Wierus/GarageClock/Data/Photo/Device.JPG

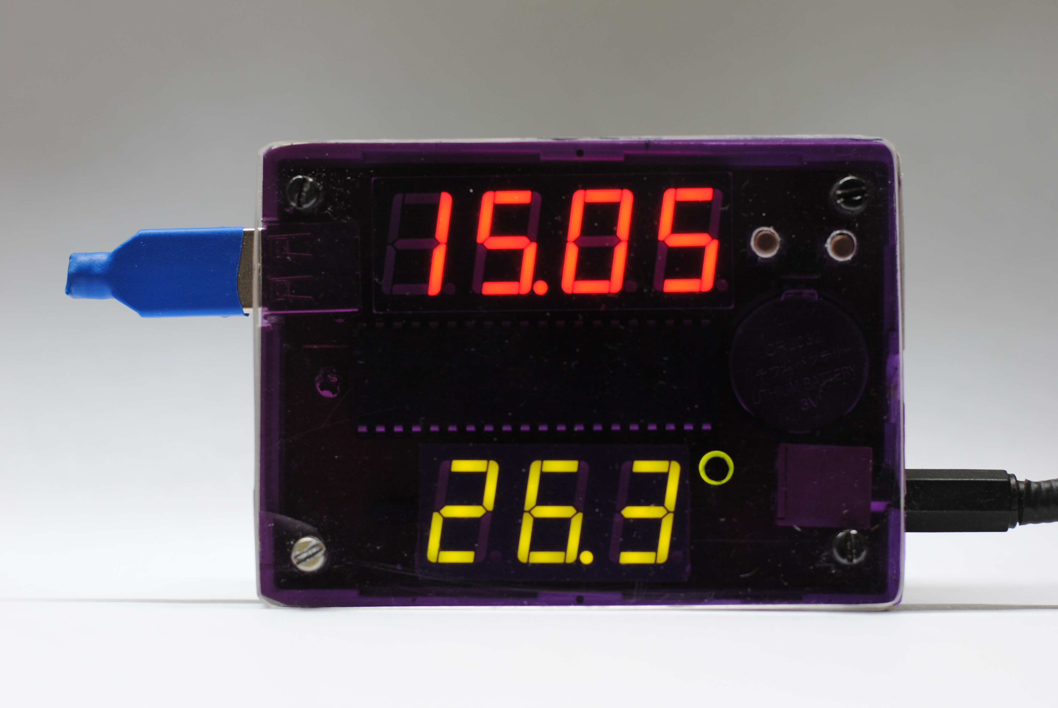
Data/Photo/Device.JPG
