Wierus/GarageClock/Data/Photo/PCB Back.JPG

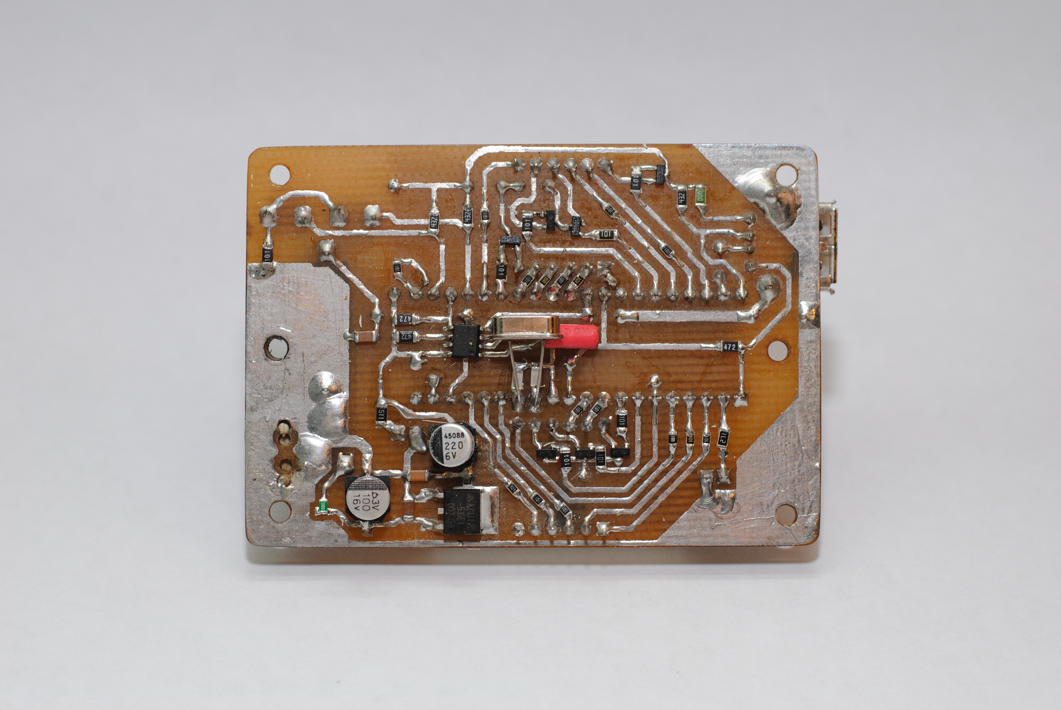
Data/Photo/PCB Back.JPG
