Wierus/GarageClock/README.md

## Часы с датчиком температуры DS18B20 на разных индикаторах

**Контроллер:** PIC16F877 (PIC16F877-04I/P, DIP40)

**Частота:** 20 МГц (кварцевый резонатор)

**Режим:** HS (High Speed Crystal/Resonator)

**Компилятор:** XC8 v1.33

**IDE:** MPLAB X IDE v3.20

**Индикатор часов:** E40561-I-O-O-W (4 знака, красный, общий анод)

**Индикатор температуры:** KEM-5361AG (3 знака, зеленый, общий анод)

**Сдвиговый регистр:** отсутствует (индикаторы напрямую подключены к контроллеру)

**Часы реального времени:** DS1307 (DS1307ZN, SO8)
