Wierus/GarageClock/Data/Tasks.pdf

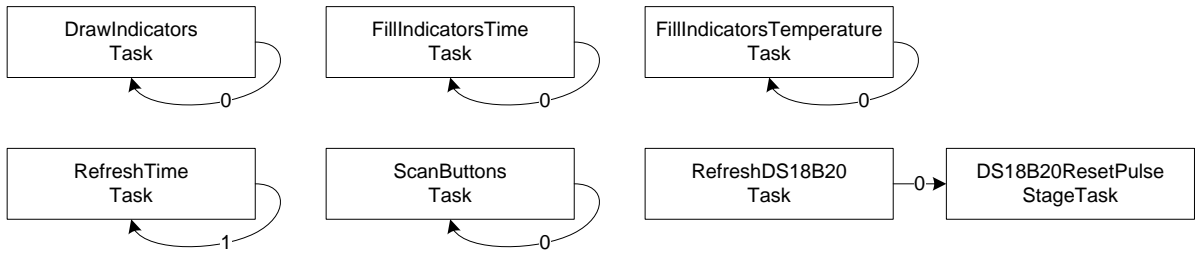
[picture p3: figure]
DrawIndicators Task; FillIndicatorsTemperature Task; ScanButtons Task; FillIndicatorsTime Task; RefreshTime Task; DS18B20ResetPulse StageTask; RefreshDS18B20; Task
