Wierus/GarageClock/Scheme/Comments.md

Выводы 6 (RA4) и 19 (RD0) контроллера PIC16F877 объединены для удобства разводки печатной платы. Вывод 6 (RA4) в схеме не используется, этот вывод программно установлен в Z-состояние (на вход).
