Wierus/GarageClock/Scheme/GarageClock (Build) (CA, CA).PDF

J1

C1

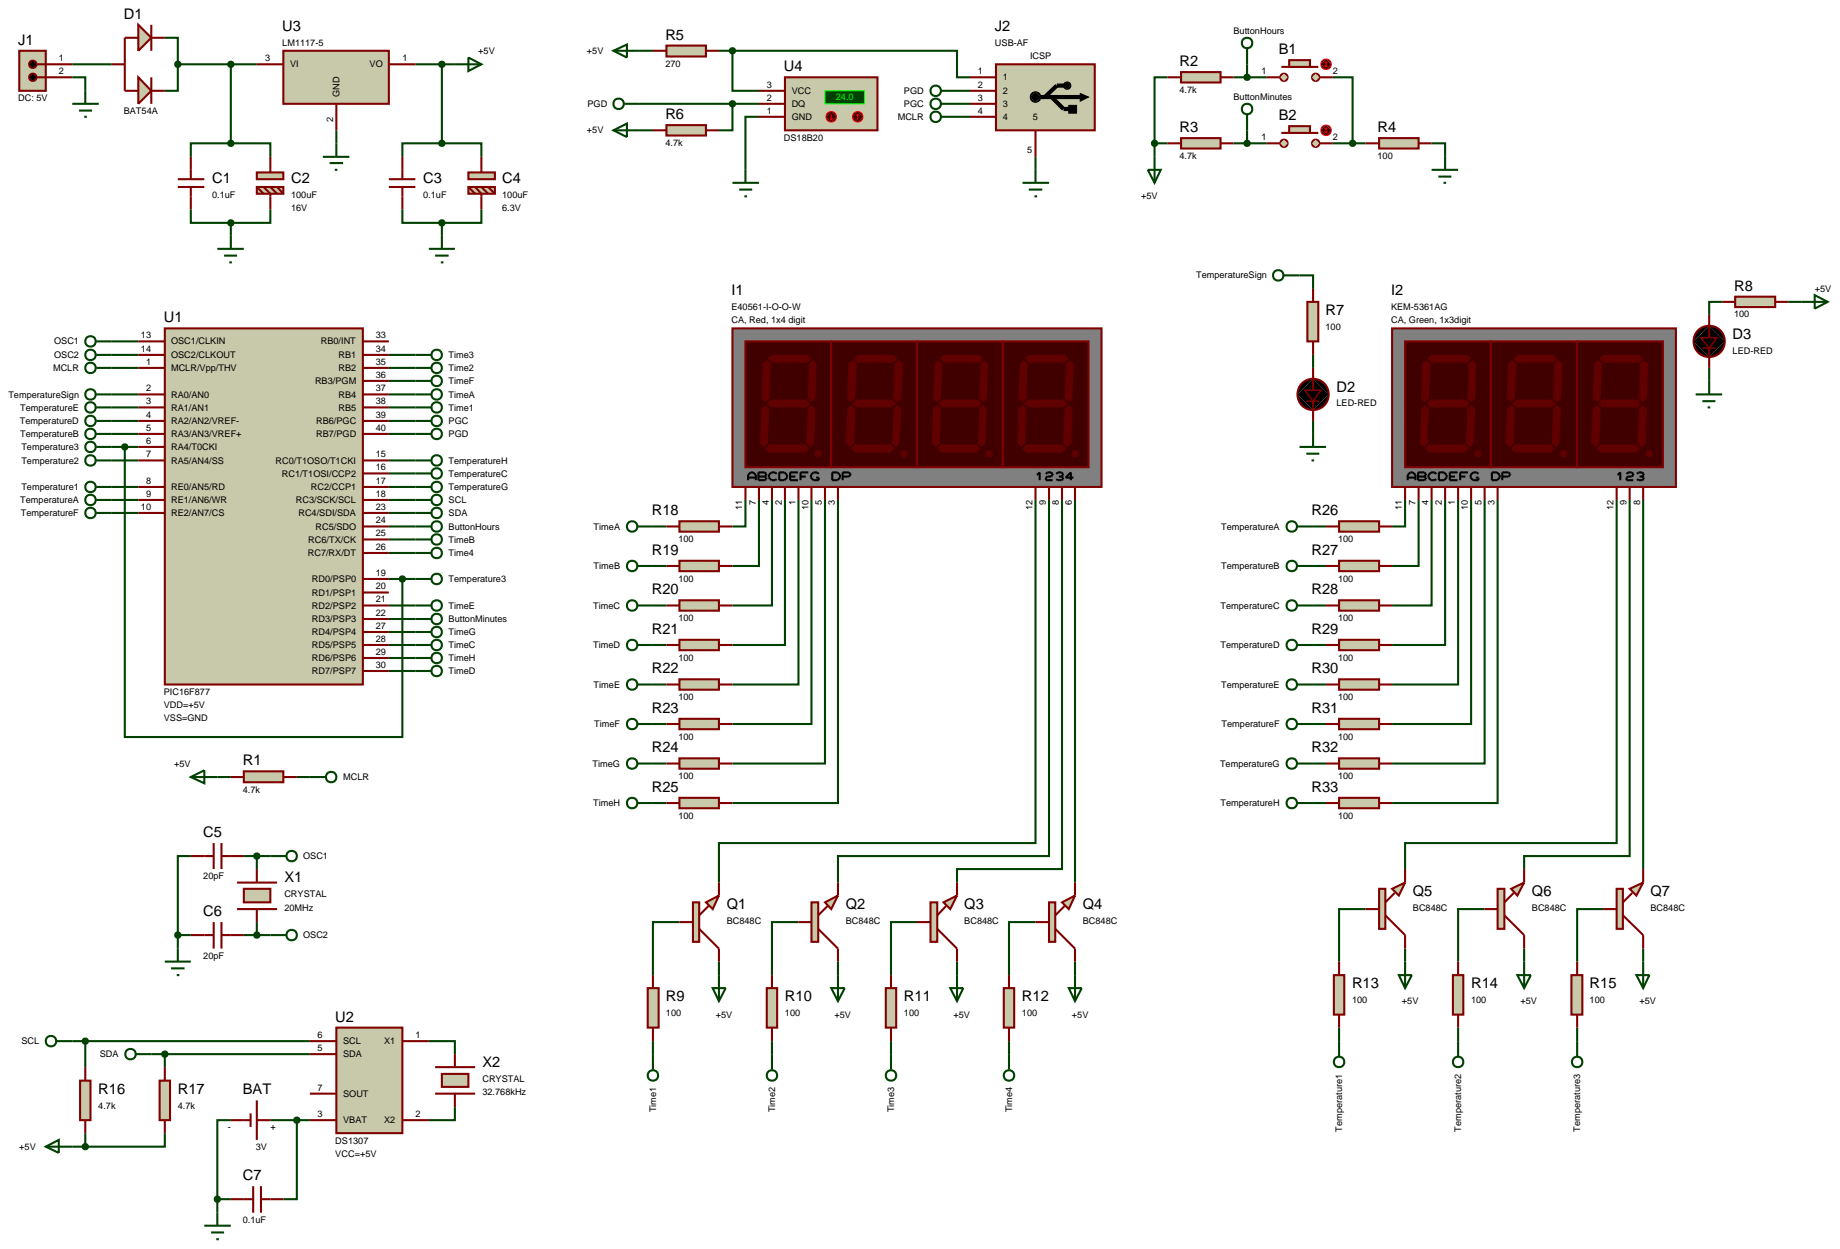
[picture p5: page 1]
