Wierus/GarageClock/(list of files, drawings)

Other design files:
Scheme/GarageClock (Build) (CA, CA).DSN
Scheme/GarageClock (Build) (CA, CA).LYT
Scheme/GarageClock (Emulation) (CA, CA).DSN
Scheme/GarageClock (Emulation) (CA, CC).DSN
