Wierus/GarageClock/(commit log)

2016-01-10 Создан пустой проект для PIC16F877 в MPLAB X IDE v3.20
2016-01-21 Добавлен файл .gitignore
2016-01-21 Добавлена программа
2016-01-21 Добавлены схема и печатная плата
    [GarageClock (Build) (CA, CA).DSN, GarageClock (Build) (CA, CA).LYT, GarageClock (Emulation) (CA, CA).DSN, GarageClock (Emulation) (CA, CC).DSN]
2016-01-21 Добавлен PDF-файл схемы
2016-01-21 Добавлены фотографии
2016-01-21 Добавлен граф задач
2016-01-21 Добавлен комментарий к схеме
2016-01-21 Изменена программа для индикатора температуры с общим катодом
2016-01-24 Исправлен NumbersOutput
2016-02-03 Исправлено имя файла SevenSegmentDisplay.c
2016-02-03 Обновлены библиотеки
2016-02-06 Обновлена библиотека DS18B20
2016-02-06 Обновлены библиотеки; для сборки проекта свойство "managed-stack" установлено в "true"; обновлен граф задач
2016-02-06 Изменена программа для индикатора температуры с общим анодом
2016-02-07 Инициализация регистра TRISE вынесена в функцию
2016-02-07 Функции инициализации сделаны инлайновыми
2016-02-23 Обновлены библиотеки, работа с датчиком DS18B20 переведена на асинхронный режим
2016-02-23 В схеме эмуляции для датчика DS18B20 значение свойства "Time Reset Low" установлено в "2ms"
    [GarageClock (Emulation) (CA, CA).DSN, GarageClock (Emulation) (CA, CC).DSN]
2016-02-23 Обновлен граф задач
2016-02-23 Удалены ненужные файлы
